Lucas-el-pato/IIS_CubeSat_2026/OBC/OBC_KICAD/OBC_KICAD.kicad_pcb

## KiCad design OBC/OBC_KICAD/OBC_KICAD.kicad_pcb (2026-05-04)

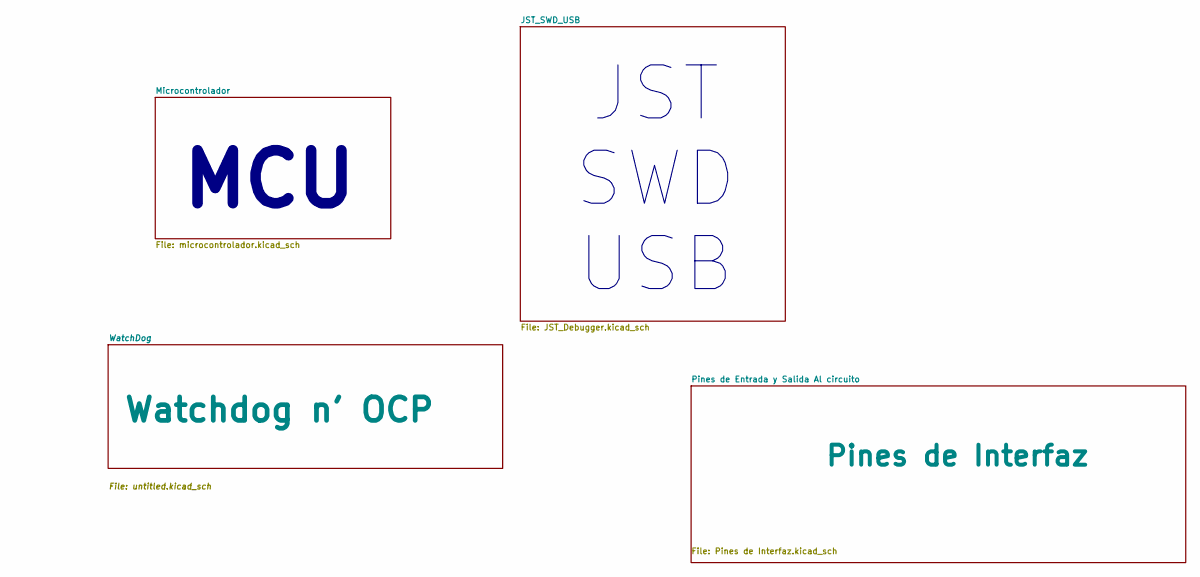
[picture p1: schematic OBC_KICAD.kicad_sch]

Notes on the sheet:
JST SWD USB
MCU

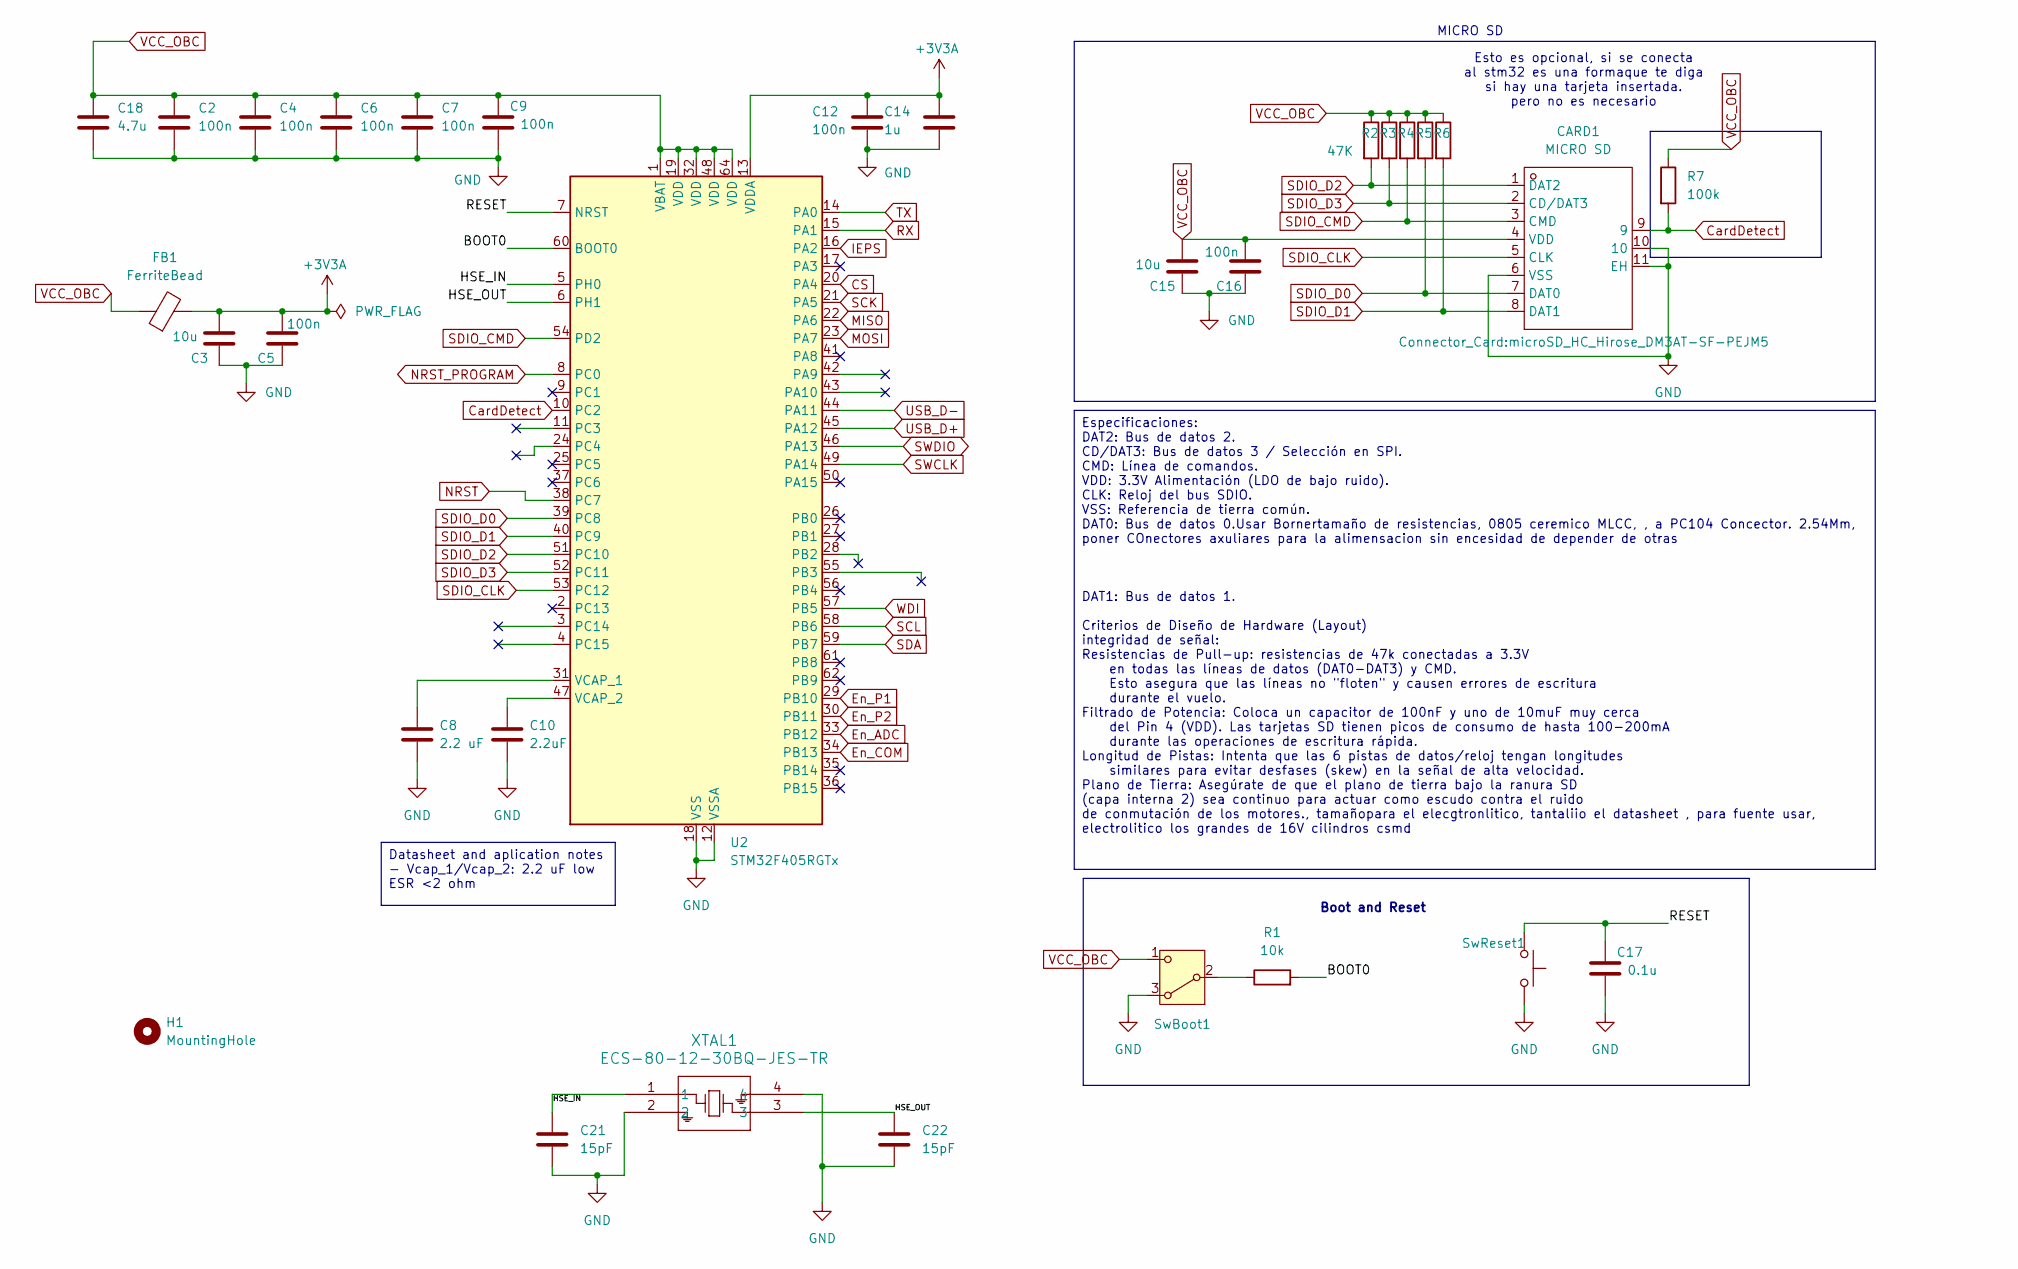
[picture p2: schematic microcontrolador.kicad_sch, David_Moises_Garcia_Sopino_Hoja1_IIS]

Parts:
C2, C4, C5, C6, C7, C9, C12, C16: 100n; C_0805_2012Metric_Pad1.18x1.45mm_HandSolder
C3, C15: 10u; C_0805_2012Metric_Pad1.18x1.45mm_HandSolder
C8: 2.2 uF; C_0805_2012Metric_Pad1.18x1.45mm_HandSolder
C10: 2.2uF; C_0805_2012Metric_Pad1.18x1.45mm_HandSolder
C14: 1u; C_0805_2012Metric_Pad1.18x1.45mm_HandSolder
C17: 0.1u; C_0805_2012Metric_Pad1.18x1.45mm_HandSolder
C18: 4.7u; C_0805_2012Metric_Pad1.18x1.45mm_HandSolder
C21, C22: 15pF; C_0805_2012Metric_Pad1.18x1.45mm_HandSolder
CARD1: MICRO SD; microSD_HC_Hirose_DM3AT-SF-PEJM5; LCSC Part Name 自弹式 MicroSD卡(TF卡) 卡座
FB1: FerriteBead; L_Walsin_WLFM252009x
H1: MountingHole; MountingHole_3.2mm_M3_Pad_Via
R1: 10k; R_0805_2012Metric_Pad1.20x1.40mm_HandSolder
R2, R3, R4, R5, R6: 47K; R_0805_2012Metric_Pad1.20x1.40mm_HandSolder
R7: 100k; R_0805_2012Metric_Pad1.20x1.40mm_HandSolder
SwBoot1: SW_Nidec_CAS-120A1; Nidec_Copal_CAS-120A
SwReset1: SW_Push; SW_Push_1P1T_NO_CK_PTS125Sx43PSMTR
U2: STM32F405RGTx; LQFP-64_10x10mm_P0.5mm
XTAL1: ECS-80-12-30BQ-JES-TR; ECS-80-12_ECS

Connections:
+3V3A: C3.2, C5.2, C12.1, C14.1, FB1.2, U2.13 (VDDA)
/Microcontrolador/BOOT0: R1.2, U2.60 (BOOT0)
/Microcontrolador/HSE_IN: C21.1, U2.5 (PH0), XTAL1.1
/Microcontrolador/HSE_OUT: C22.1, U2.6 (PH1), XTAL1.3
/Microcontrolador/RESET: C17.1, SwReset1.2, U2.7 (NRST)
CS: U2.20 (PA4); also elsewhere on the board
CardDetect: CARD1.9, R7.2, U2.10 (PC2)
En_ADC: U2.33 (PB12); also elsewhere on the board
En_COM: U2.34 (PB13); also elsewhere on the board
En_P1: U2.29 (PB10); also elsewhere on the board
En_P2: U2.30 (PB11); also elsewhere on the board
GND: C2.2, C3.1, C4.2, C5.1, C6.2, C7.2, C8.2, C9.2, C10.2, C12.2, C14.2, C15.1, C16.1, C17.2, C18.2, C21.2, C22.2, CARD1.6 (VSS), CARD1.10, CARD1.11 (EH), SwBoot1.3 (A), SwReset1.1, U2.12 (VSSA), U2.18 (VSS), U2.63 (VSS), XTAL1.2, XTAL1.4; also elsewhere on the board
IEPS: U2.16 (PA2); also elsewhere on the board
MISO: U2.22 (PA6); also elsewhere on the board
MOSI: U2.23 (PA7); also elsewhere on the board
NRST: U2.38 (PC7); also elsewhere on the board
NRST_PROGRAM: U2.8 (PC0); also elsewhere on the board
unnamed: R1.1, SwBoot1.2 (B)
unnamed: C8.1, U2.31 (VCAP_1)
unnamed: C10.1, U2.47 (VCAP_2)
RX: U2.15 (PA1); also elsewhere on the board
SCK: U2.21 (PA5); also elsewhere on the board
SCL: U2.58 (PB6); also elsewhere on the board
SDA: U2.59 (PB7); also elsewhere on the board
SDIO_CLK: CARD1.5 (CLK), U2.53 (PC12)
SDIO_CMD: CARD1.3 (CMD), R4.2, U2.54 (PD2)
SDIO_D0: CARD1.7 (DAT0), R5.2, U2.39 (PC8)
SDIO_D1: CARD1.8 (DAT1), R6.2, U2.40 (PC9)
SDIO_D2: CARD1.1 (DAT2), R2.2, U2.51 (PC10)
SDIO_D3: CARD1.2 (CD/DAT3), R3.2, U2.52 (PC11)
SWCLK: U2.49 (PA14); also elsewhere on the board
SWDIO: U2.46 (PA13); also elsewhere on the board
TX: U2.14 (PA0); also elsewhere on the board
USB_D+: U2.45 (PA12); also elsewhere on the board
USB_D-: U2.44 (PA11); also elsewhere on the board
VCC_OBC: C2.1, C4.1, C6.1, C7.1, C9.1, C15.2, C16.2, C18.1, CARD1.4 (VDD), FB1.1, R2.1, R3.1, R4.1, R5.1, R6.1, R7.1, SwBoot1.1 (C), U2.1 (VBAT), U2.19 (VDD), U2.32 (VDD), U2.48 (VDD), U2.64 (VDD); also elsewhere on the board
WDI: U2.57 (PB5); also elsewhere on the board

Notes on the sheet:
Esto es opcional, si se conecta al stm32 es una formaque te diga si hay una tarjeta insertada. pero no es necesario
Boot and Reset
MICRO SD
Datasheet and aplication notes - Vcap_1/Vcap_2: 2.2 uF low ESR <2 ohm
Especificaciones: DAT2: Bus de datos 2. CD/DAT3: Bus de datos 3 / Selección en SPI. CMD: Línea de comandos. VDD: 3.3V Alimentación (LDO de bajo ruido). CLK: Reloj del bus SDIO. VSS: Referencia de tierra común. DAT0: Bus de datos 0.Usar Bornertamaño de resistencias, 0805 ceremico MLCC, , a PC104 Con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

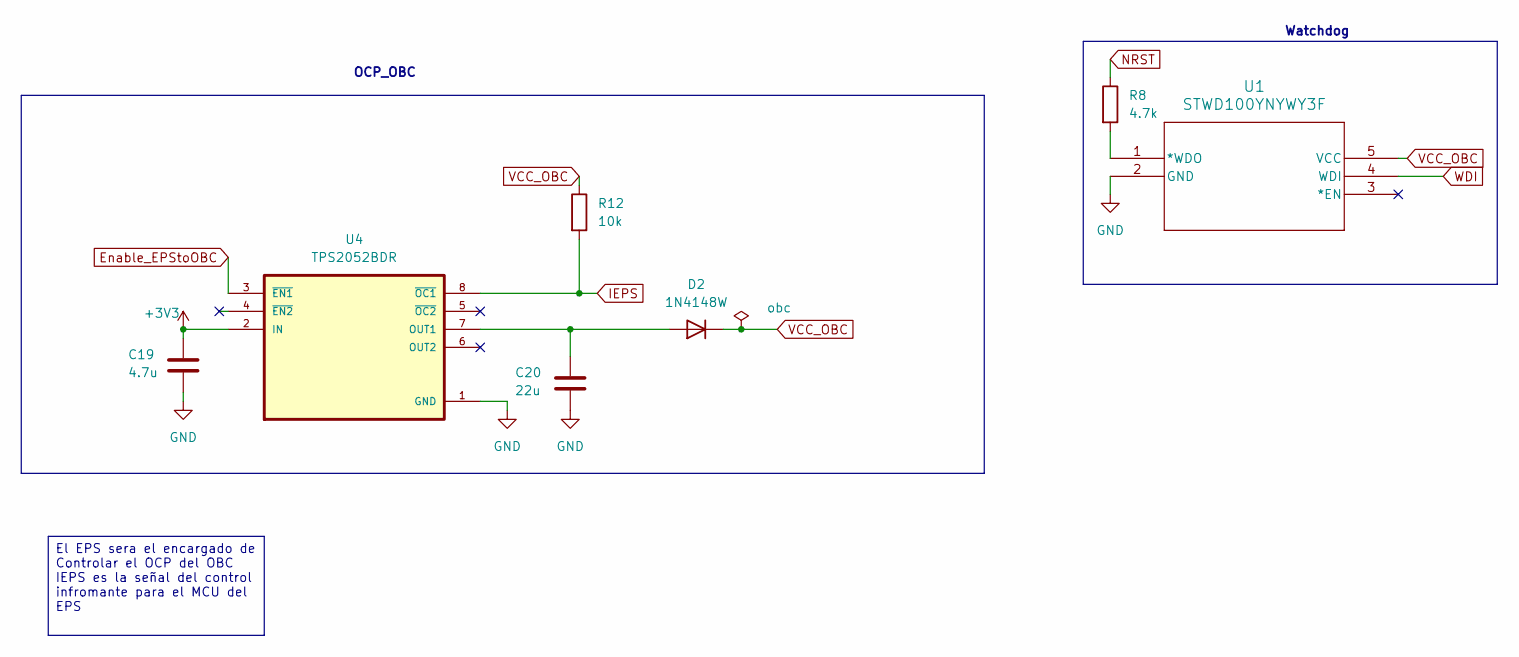
[picture p3: schematic untitled.kicad_sch, David_Moises_Garcia_Sopino_Hoja3_IIS]

Parts:
C19: 4.7u; C_0805_2012Metric_Pad1.18x1.45mm_HandSolder
C20: 22u; C_0805_2012Metric_Pad1.18x1.45mm_HandSolder
D2: 1N4148W; D_SOD-123
R8: 4.7k; R_0805_2012Metric_Pad1.20x1.40mm_HandSolder
R12: 10k; R_0805_2012Metric_Pad1.20x1.40mm_HandSolder
U1: STWD100YNYWY3F; SOP95P280X145-5N
U4: TPS2052BDR; SOIC127P599X175-8N

Connections:
+3V3: C19.1, U4.2 (IN); also elsewhere on the board
Enable_EPStoOBC: U4.3 (~EN1); also elsewhere on the board
GND: C19.2, C20.2, U1.2 (GND), U4.1 (GND); also elsewhere on the board
IEPS: R12.2, U4.8 (~OC1); also elsewhere on the board
NRST: R8.1; also elsewhere on the board
unnamed: C20.1, D2.2 (A), U4.7 (OUT1)
unnamed: R8.2, U1.1 (*WDO)
VCC_OBC: D2.1 (K), R12.1, U1.5 (VCC); also elsewhere on the board
WDI: U1.4 (WDI); also elsewhere on the board

Notes on the sheet:
OCP_OBC
Watchdog
El EPS sera el encargado de Controlar el OCP del OBC IEPS es la señal del control infromante para el MCU del EPS

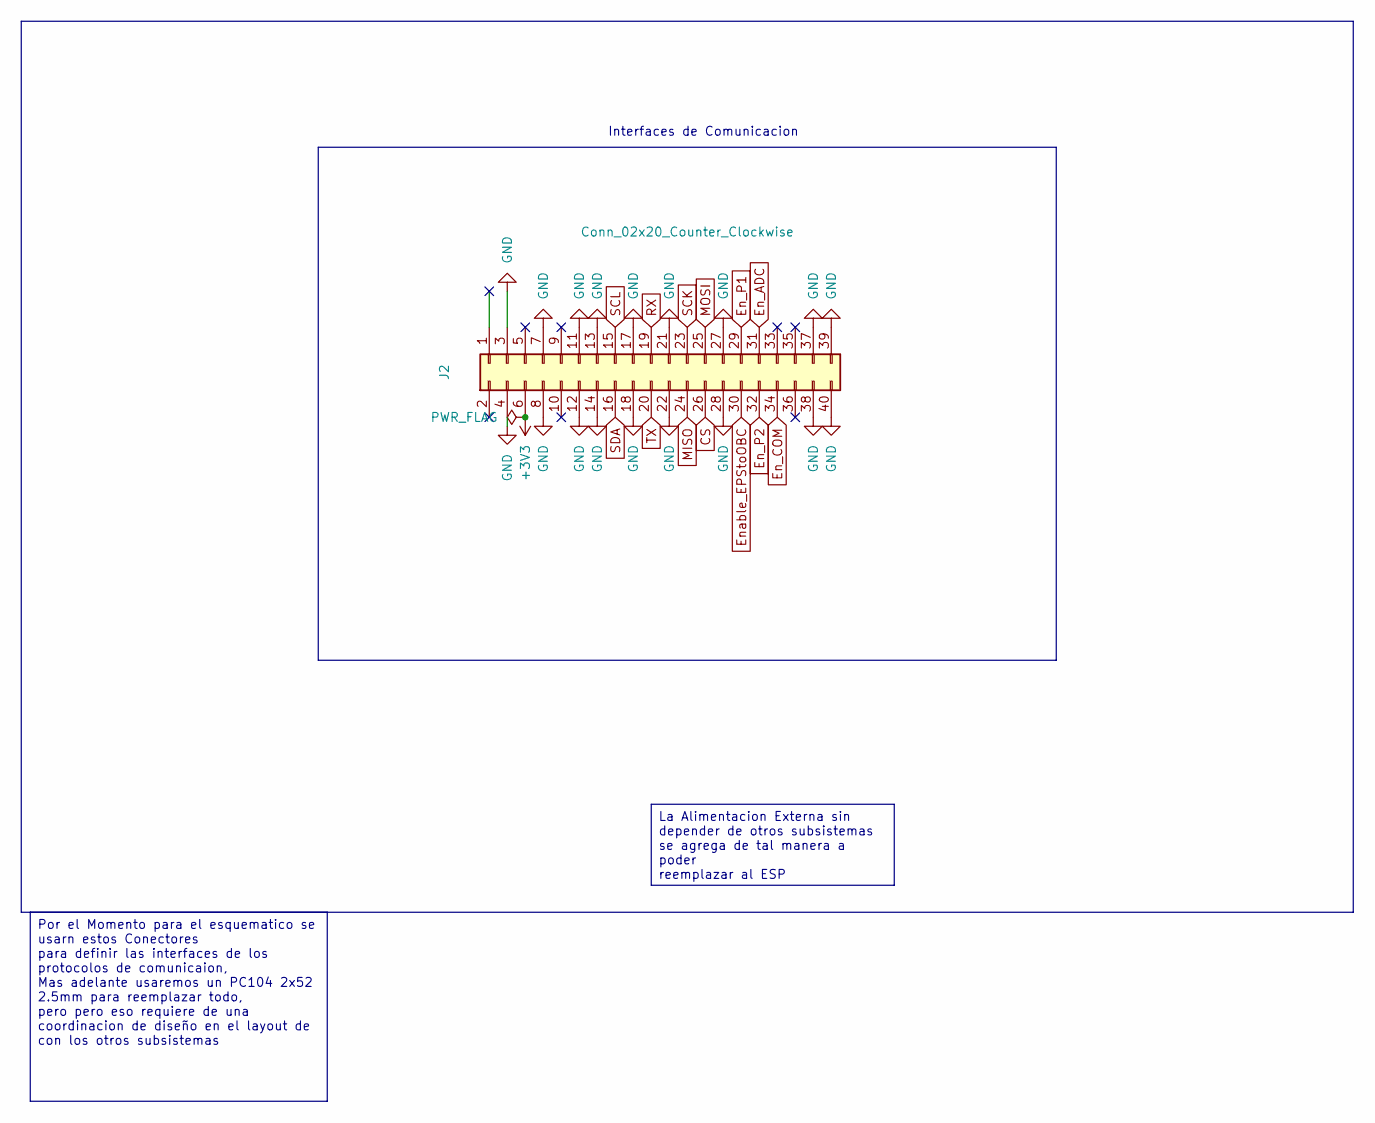
[picture p4: schematic Pines de Interfaz.kicad_sch, David_Moises_Garcia_Sopino_Hoja4_IIS]

Parts:
J2: Conn_02x20_Counter_Clockwise; PinSocket_2x20_P2.54mm_Vertical

Connections:
+3V3: J2.6; also elsewhere on the board
CS: J2.26; also elsewhere on the board
En_ADC: J2.31; also elsewhere on the board
En_COM: J2.34; also elsewhere on the board
En_P1: J2.29; also elsewhere on the board
En_P2: J2.32; also elsewhere on the board
Enable_EPStoOBC: J2.30; also elsewhere on the board
GND: J2.3, J2.4, J2.7, J2.8, J2.11, J2.12, J2.13, J2.14, J2.17, J2.18, J2.21, J2.22, J2.27, J2.28, J2.37 (Pin_38), J2.38, J2.39 (Pin_39}), J2.40; also elsewhere on the board
MISO: J2.24; also elsewhere on the board
MOSI: J2.25; also elsewhere on the board
RX: J2.19; also elsewhere on the board
SCK: J2.23; also elsewhere on the board
SCL: J2.15; also elsewhere on the board
SDA: J2.16; also elsewhere on the board
TX: J2.20; also elsewhere on the board

Notes on the sheet:
Interfaces de Comunicacion
Por el Momento para el esquematico se usarn estos Conectores para definir las interfaces de los protocolos de comunicaion, Mas adelante usaremos un PC104 2x52 2.5mm para reemplazar todo, pero pero eso requiere de una coordinacion de diseño en el layout de con los otros subsistemas
La Alimentacion Externa sin depender de otros subsistemas se agrega de tal manera a poder reemplazar al ESP

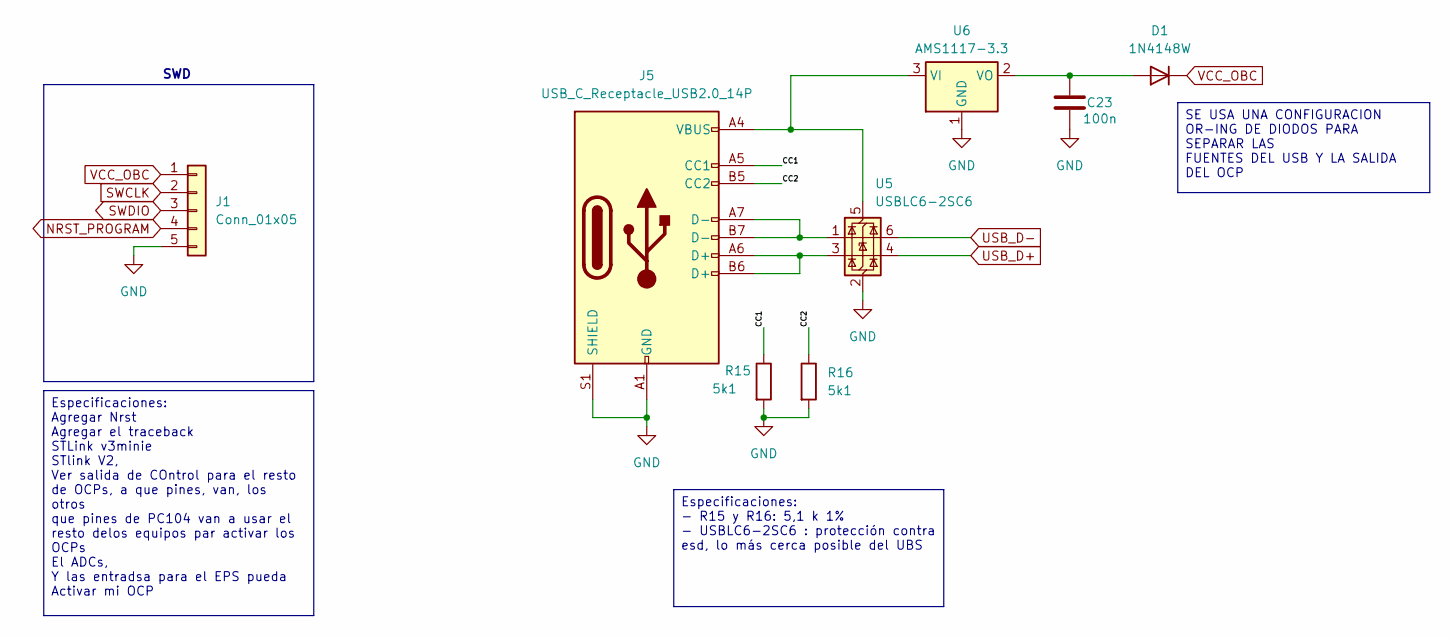
[picture p5: schematic JST_Debugger.kicad_sch, David_Moises_Garcia_Sopino_Hoja2_IIS]

Parts:
C23: 100n; C_0805_2012Metric_Pad1.18x1.45mm_HandSolder
D1: 1N4148W; D_SOD-123
J1: Conn_01x05; PinSocket_1x05_P2.54mm_Vertical_SMD_Pin1Left
J5: USB_C_Receptacle_USB2.0_14P; USB_C_Receptacle_GCT_USB4110
R15, R16: 5k1; R_0805_2012Metric_Pad1.20x1.40mm_HandSolder
U5: USBLC6-2SC6; SOT-23-6
U6: AMS1117-3.3; SOT-223-3_TabPin2

Connections:
/JST_SWD_USB/CC1: J5.A5 (CC1), R15.1
/JST_SWD_USB/CC2: J5.B5 (CC2), R16.1
GND: C23.2, J1.5, J5.A1 (GND), J5.A12 (GND), J5.B1 (GND), J5.B12 (GND), J5.S1 (SHIELD), R15.2, R16.2, U5.2 (GND), U6.1 (GND); also elsewhere on the board
NRST_PROGRAM: J1.4; also elsewhere on the board
unnamed: C23.1, D1.2 (A), U6.2 (VO)
unnamed: J5.A6 (D+), J5.B6 (D+), U5.3 (I/O2)
unnamed: J5.A7 (D-), J5.B7 (D-), U5.1 (I/O1)
unnamed: J5.A4 (VBUS), J5.A9 (VBUS), J5.B4 (VBUS), J5.B9 (VBUS), U5.5 (VBUS), U6.3 (VI)
SWCLK: J1.2; also elsewhere on the board
SWDIO: J1.3; also elsewhere on the board
USB_D+: U5.4 (I/O2); also elsewhere on the board
USB_D-: U5.6 (I/O1); also elsewhere on the board
VCC_OBC: D1.1 (K), J1.1; also elsewhere on the board

Notes on the sheet:
SWD
Especificaciones: Agregar Nrst Agregar el traceback STLink v3minie STlink V2, Ver salida de COntrol para el resto de OCPs, a que pines, van, los otros que pines de PC104 van a usar el resto delos equipos par activar los OCPs El ADCs, Y las entradsa para el EPS pueda Activar mi OCP
SE USA UNA CONFIGURACION OR-ING DE DIODOS PARA SEPARAR LAS FUENTES DEL USB Y LA SALIDA DEL OCP
Especificaciones: - R15 y R16: 5,1 k 1% - USBLC6-2SC6 : protección contra esd, lo más cerca posible del UBS

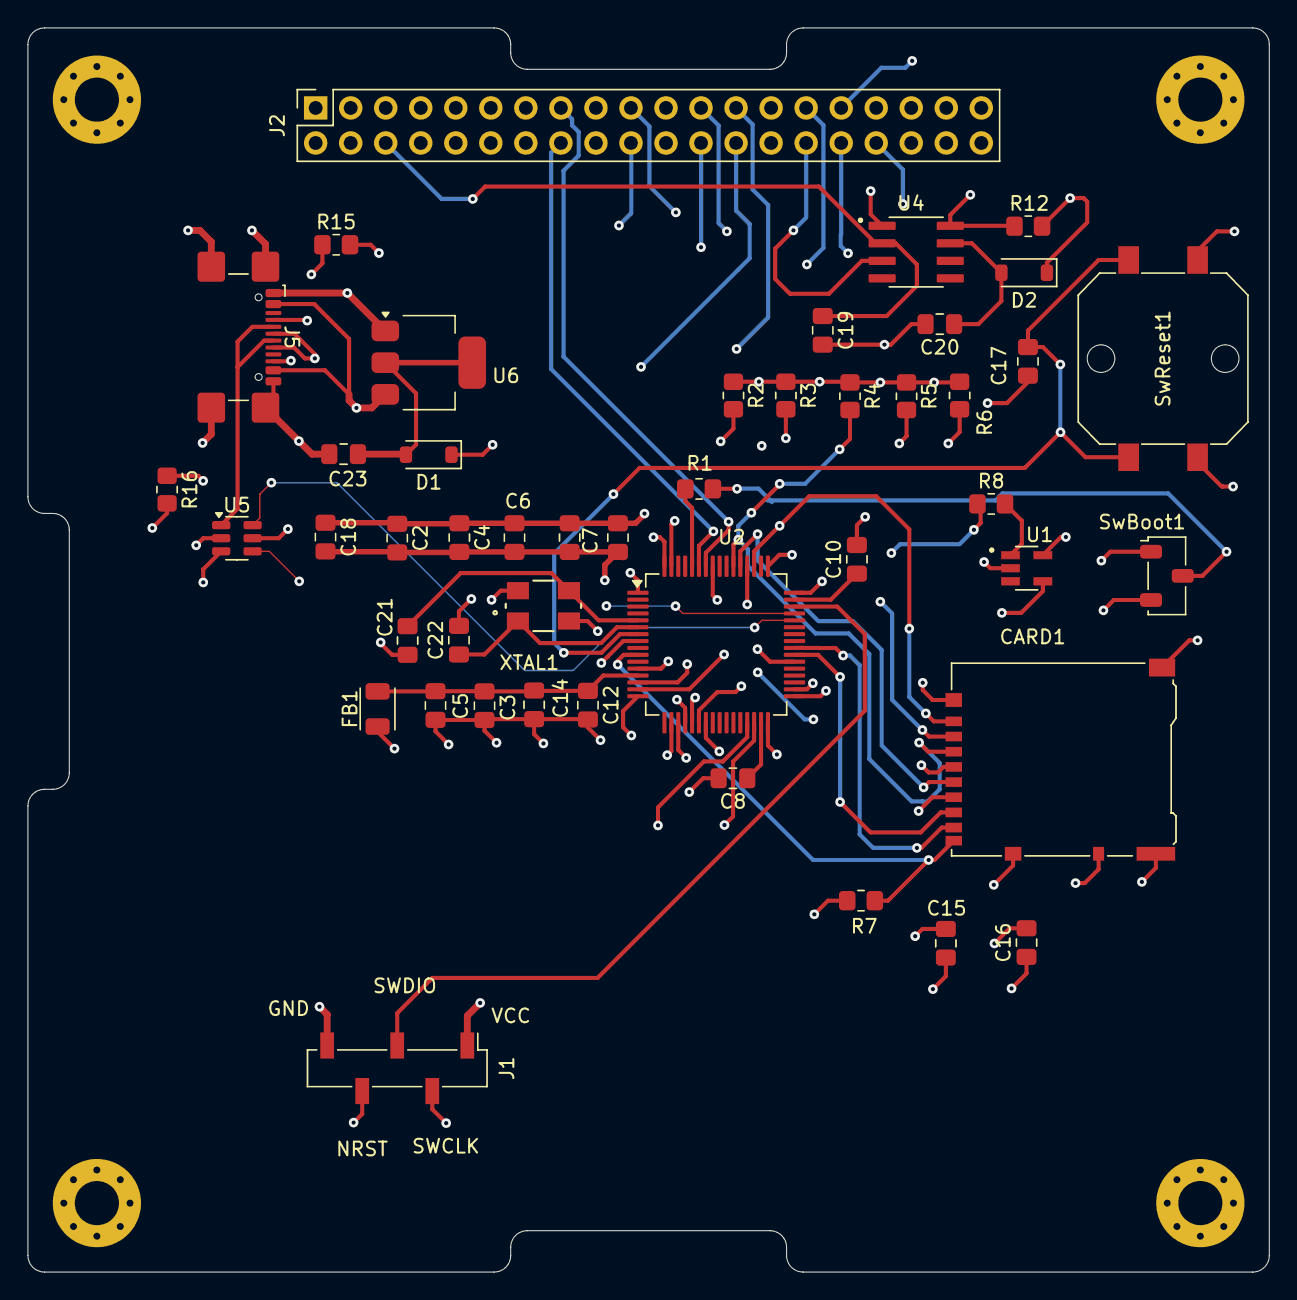
[picture p6: board OBC_KICAD.kicad_pcb from above]

Board: 4 copper layers, 90.0 x 90.2 mm, 50 parts (0 on the bottom side), 47 nets.

Other parts of the board:
H2, H3, H4: MountingHole; MountingHole_3.2mm_M3_Pad_Via
