Lucas-el-pato/IIS_CubeSat_2026/(commit log)

2026-03-07 Initial OBC Kicad
    Kicad del OBC con el STM32 y el jst para SWD y el USB
    [JST_Debugger.kicad_sch, OBC_KICAD.kicad_pcb, OBC_KICAD.kicad_sch, microcontrolador.kicad_sch]
2026-03-09 footprints y datasheets
2026-03-30 Agregar OCP TPS2052BDR y Watchdog STWD100
    Agregue un OCP y un WatchDOg ,todo en la HOja con NOmbre Wtachdog.
    [OBC_KICAD.kicad_pcb, OBC_KICAD.kicad_sch, microcontrolador.kicad_sch, untitled.kicad_sch]
2026-05-04 Cirtcuito Completo
    Circuito Completo
    [JST_Debugger.kicad_sch, OBC_KICAD.kicad_pcb, OBC_KICAD.kicad_sch, Pines de Interfaz.kicad_sch, microcontrolador.kicad_sch, untitled.kicad_sch]
